PaydenHoskins/Hex_Walker_Project/Kicad_Files/Servo_Board/3D_View.png

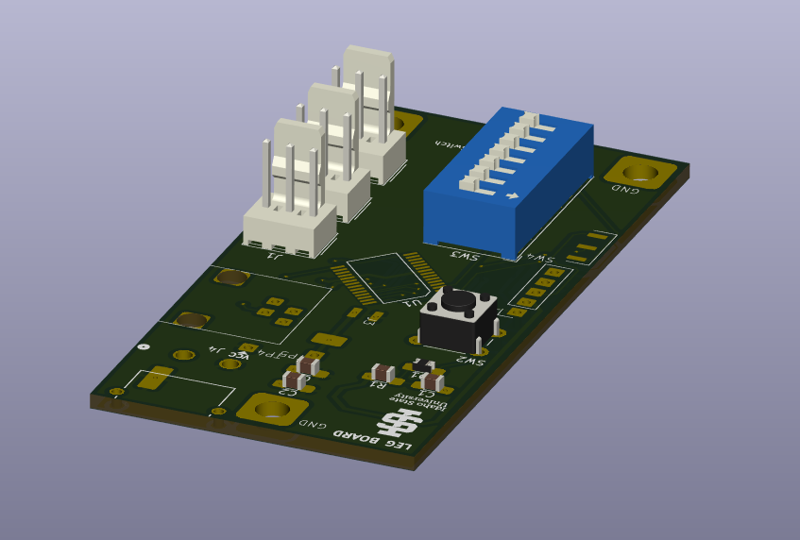
Kicad_Files/Servo_Board/3D_View.png
