PaydenHoskins/Hex_Walker_Project/Kicad_Files/Power_I2C_DistributionBoard/DistBoard.png

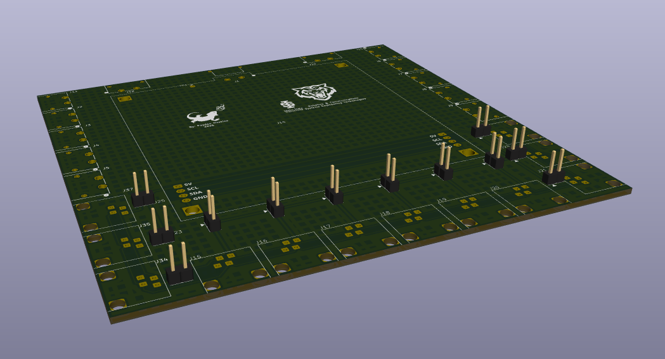
Kicad_Files/Power_I2C_DistributionBoard/DistBoard.png
