PaydenHoskins/Hex_Walker_Project/Pictures/System_Overview.drawio.pdf

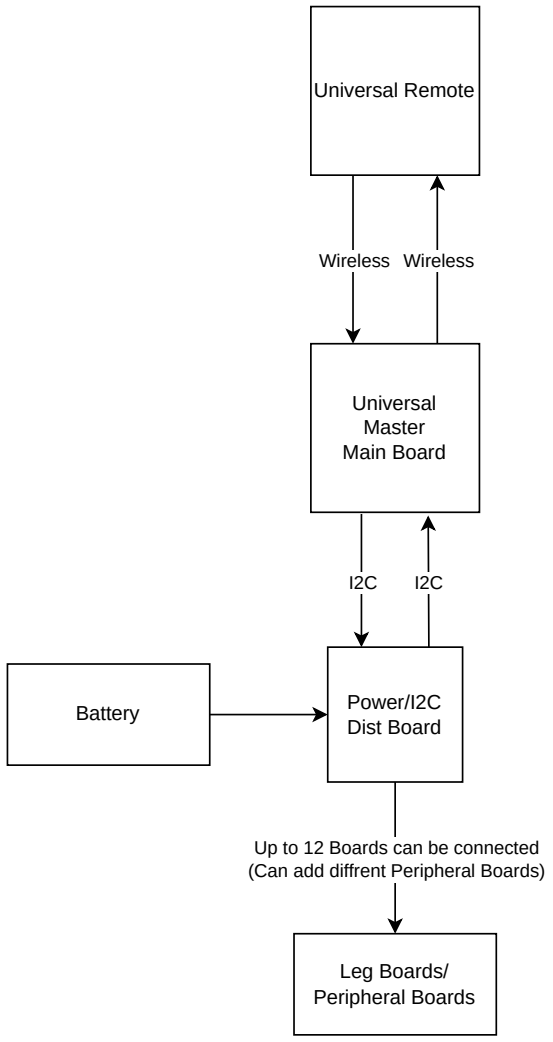
[picture p3: figure]
Universal Remote; Wireless; Universal Master Main Board; Power/I2C Dist Board Battery; Leg Boards/ Peripheral Boards; Up to 12 Boards can be connected (Can add diffrent Peripheral Boards)
