PaydenHoskins/Hex_Walker_Project/Pictures/25Kg_Leg.png

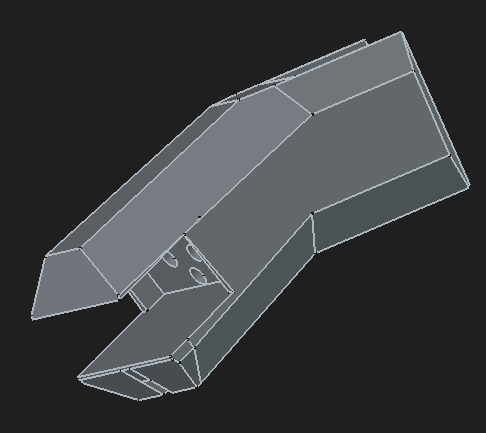
Pictures/25Kg_Leg.png
