PaydenHoskins/Hex_Walker_Project/Pictures/25Kg_Leg_MasterSketch.png

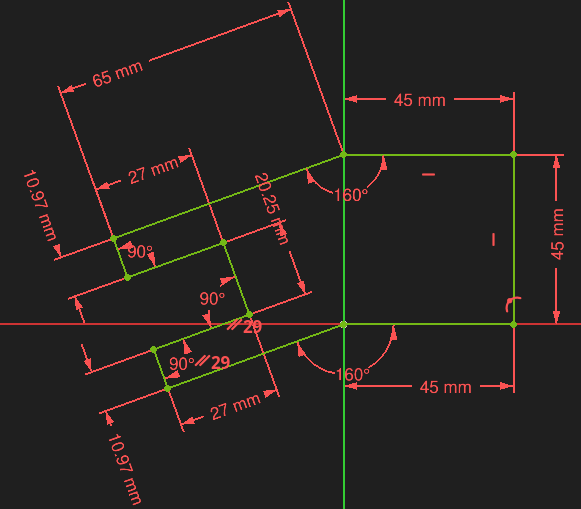
Pictures/25Kg_Leg_MasterSketch.png
