PaydenHoskins/Hex_Walker_Project/Pictures/160Kg_Foot.png

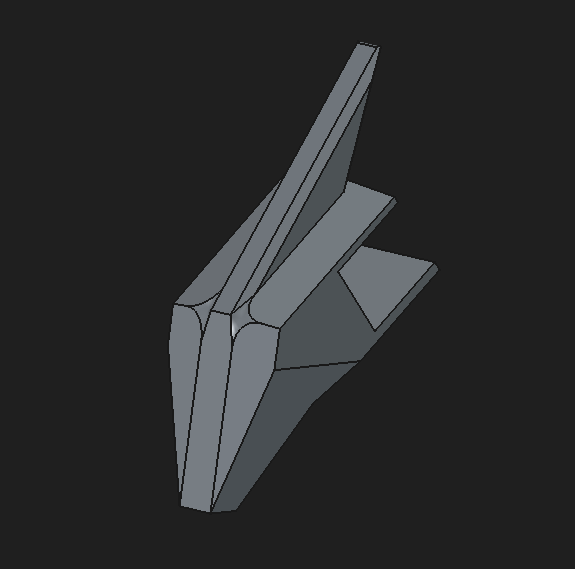
Pictures/160Kg_Foot.png
