PaydenHoskins/Hex_Walker_Project/Pictures/160Kg_Foot_MasterSketch.png

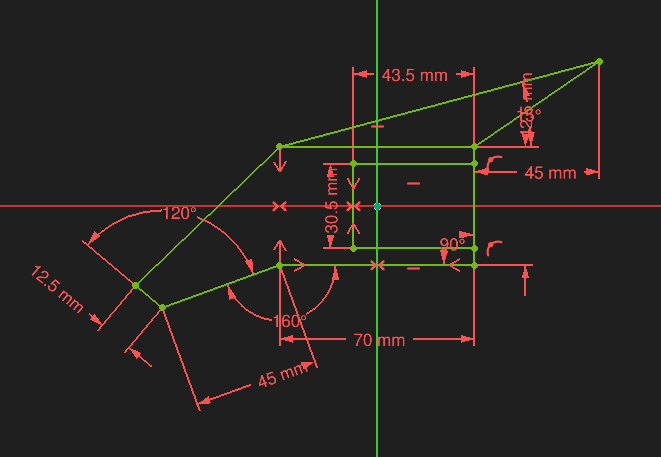
Pictures/160Kg_Foot_MasterSketch.png
