PaydenHoskins/Hex_Walker_Project/Pictures/160Kg_Leg.png

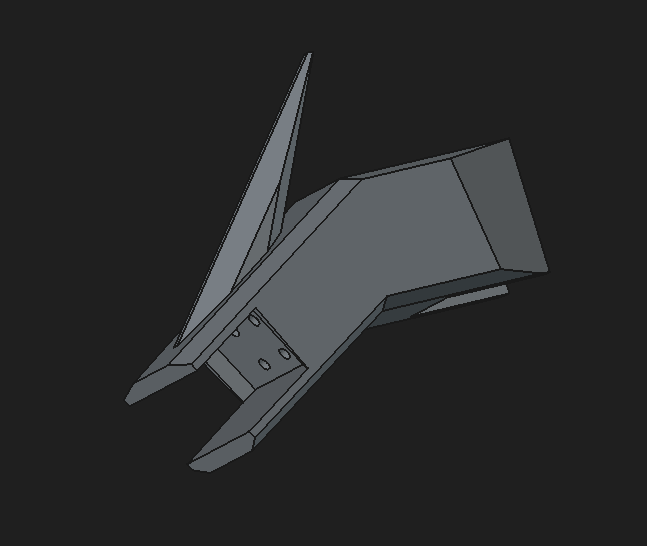
Pictures/160Kg_Leg.png
