PaydenHoskins/Hex_Walker_Project/Pictures/160Kg_Leg_MasterSketch.png

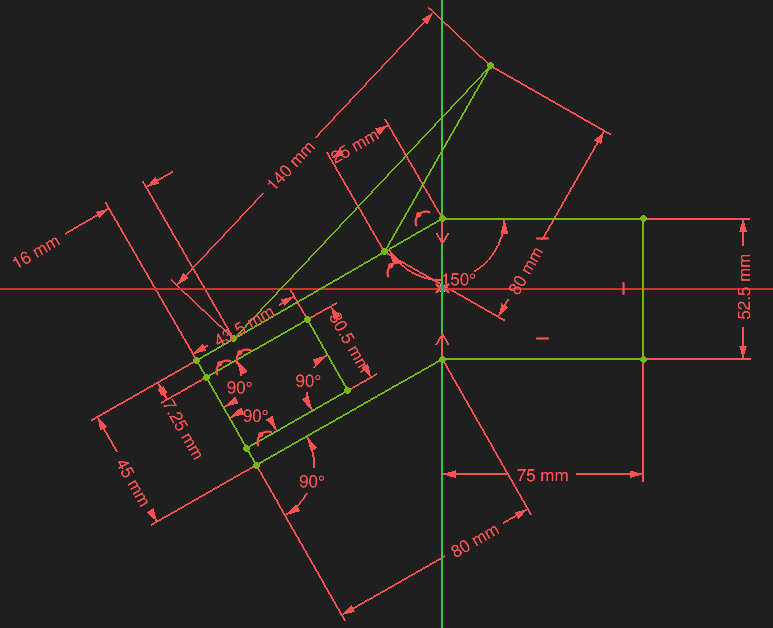
Pictures/160Kg_Leg_MasterSketch.png
