PaydenHoskins/Hex_Walker_Project/Pictures/DistBoard_I2C.png

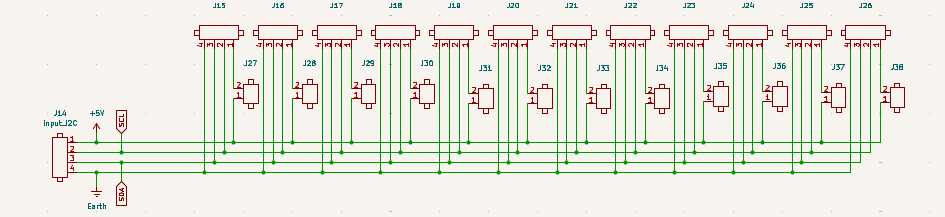
Pictures/DistBoard_I2C.png
