PaydenHoskins/Hex_Walker_Project/Pictures/Power_Board_PCB.png

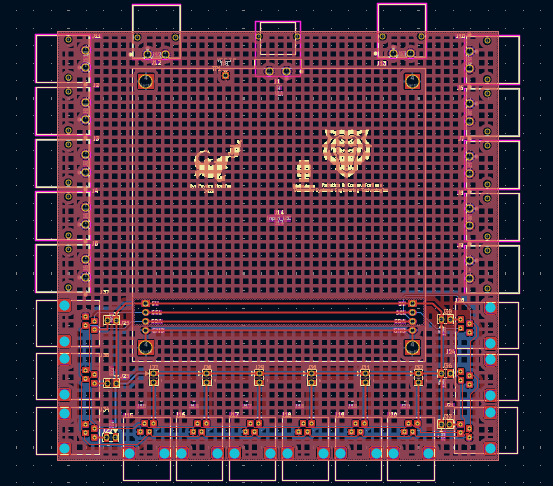
Pictures/Power_Board_PCB.png
