PaydenHoskins/Hex_Walker_Project/Pictures/Power_Board_to_Leg_Board.jpg

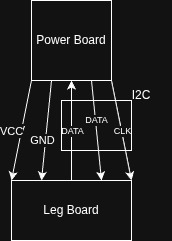
Pictures/Power_Board_to_Leg_Board.jpg
