PaydenHoskins/Hex_Walker_Project/Pictures/Screenshot_20260503_161113.png

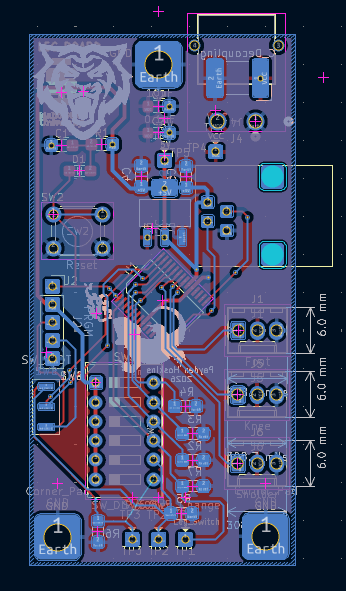
Pictures/Screenshot_20260503_161113.png
