PaydenHoskins/Hex_Walker_Project/Pictures/Servo_Board_Main_Schematic.png

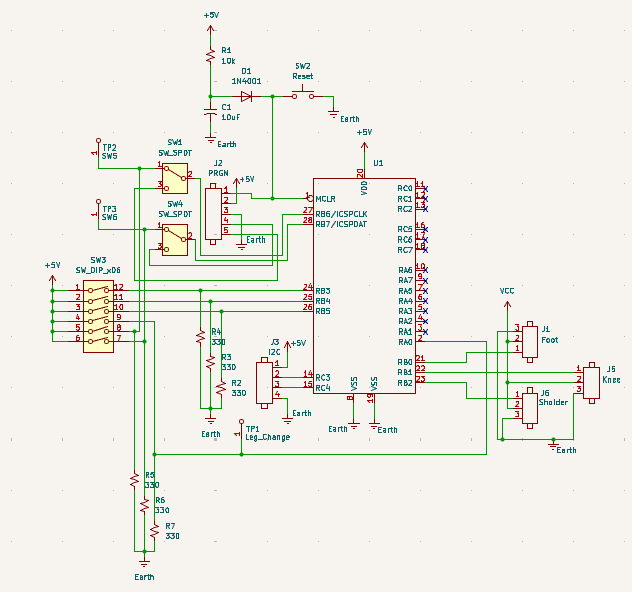
Pictures/Servo_Board_Main_Schematic.png
