PaydenHoskins/Hex_Walker_Project/Pictures/Servo_Board_PowerIn.png

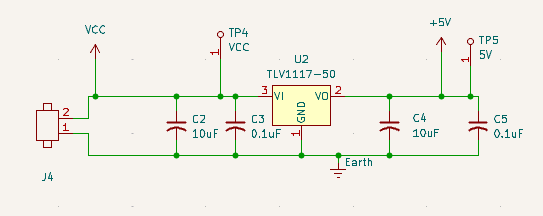
Pictures/Servo_Board_PowerIn.png
