PaydenHoskins/Hex_Walker_Project/Pictures/Servo_Connections.drawio.png

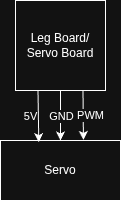
Pictures/Servo_Connections.drawio.png
