PaydenHoskins/Hex_Walker_Project/Pictures/Servo_Signal.jpeg

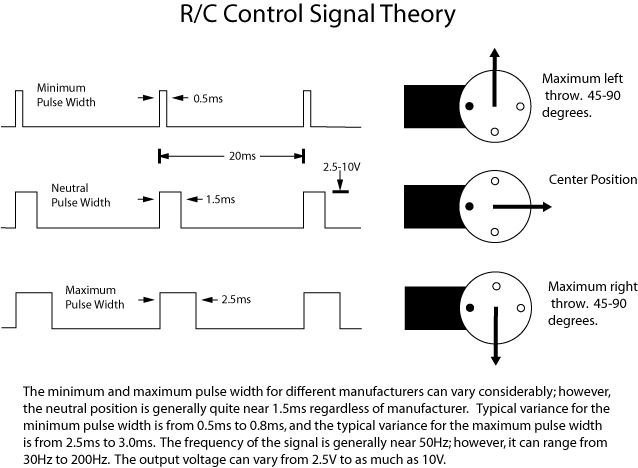
Pictures/Servo_Signal.jpeg
