PaydenHoskins/Hex_Walker_Project/Pictures/Timer2_Int2.png

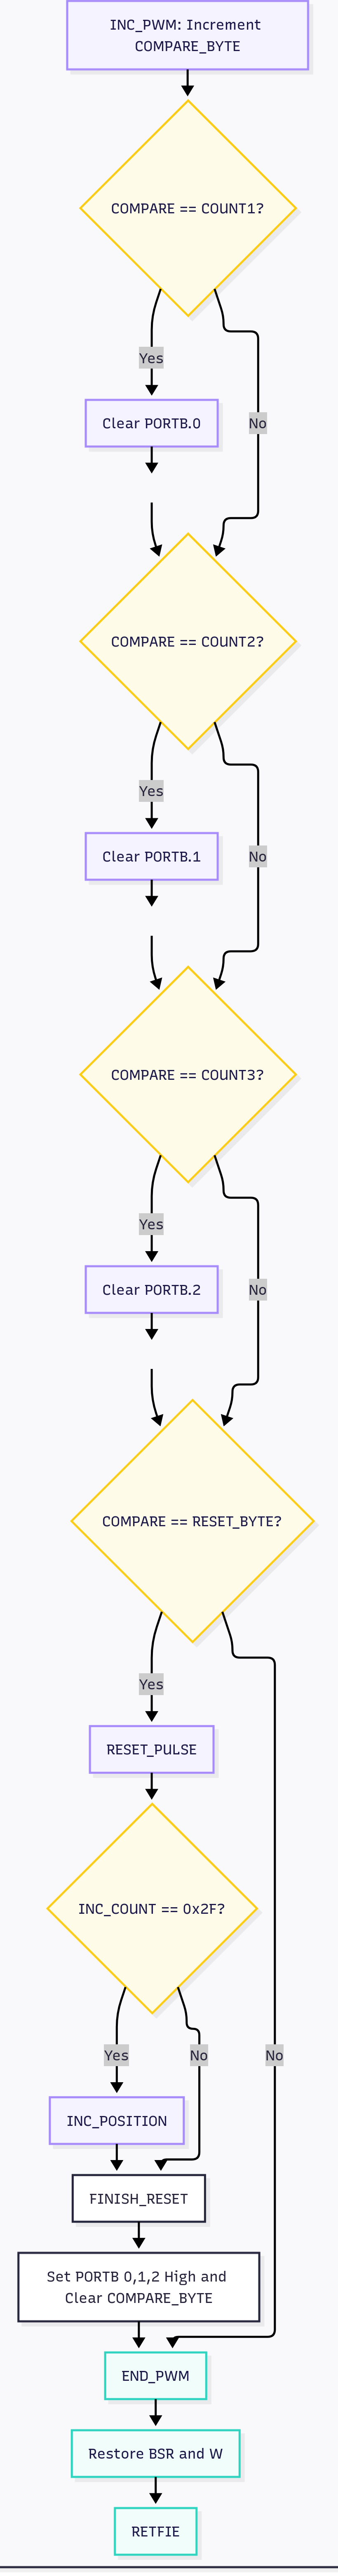
Pictures/Timer2_Int2.png
