PaydenHoskins/Hex_Walker_Project/Pictures/Timer2_Int.png

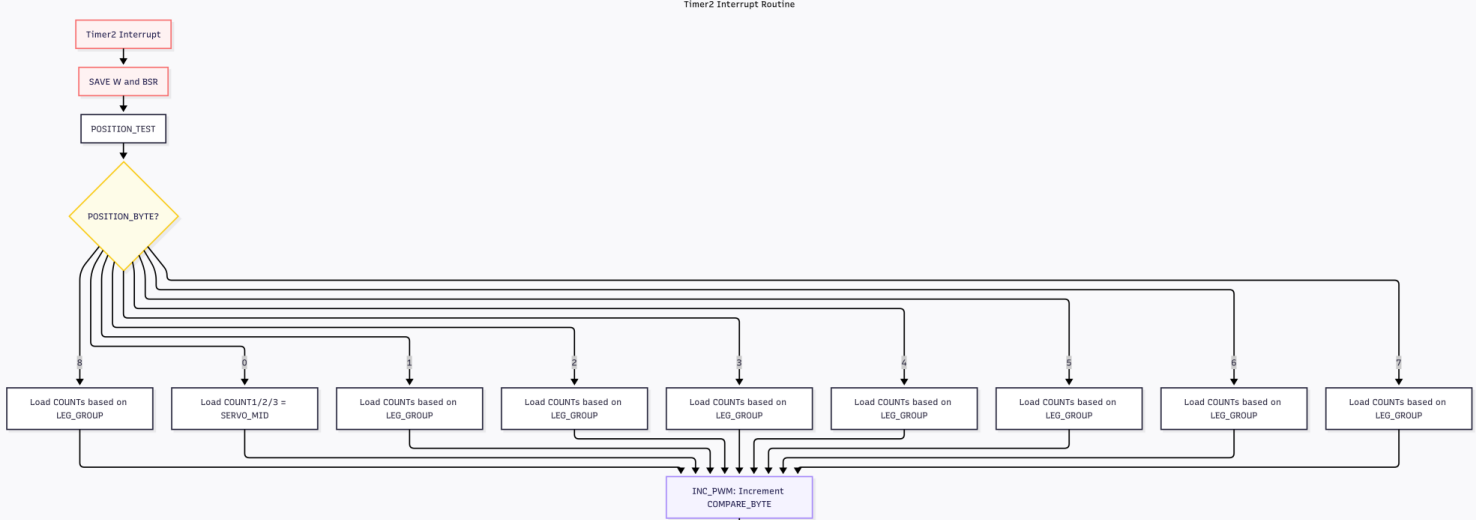
Pictures/Timer2_Int.png
