PaydenHoskins/Hex_Walker_Project/Pictures/Timer2_Start.png

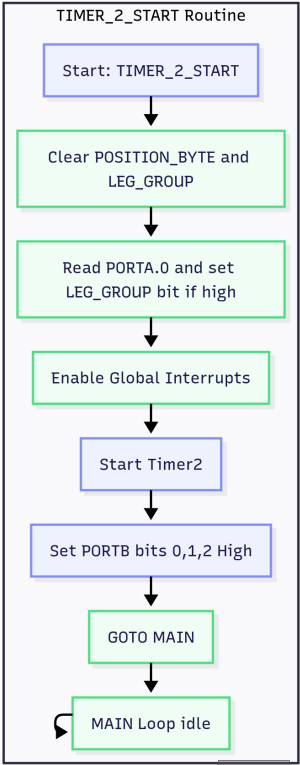
Pictures/Timer2_Start.png
