PaydenHoskins/Hex_Walker_Project/3D_Files/25Kg_Foot-Foot.stl

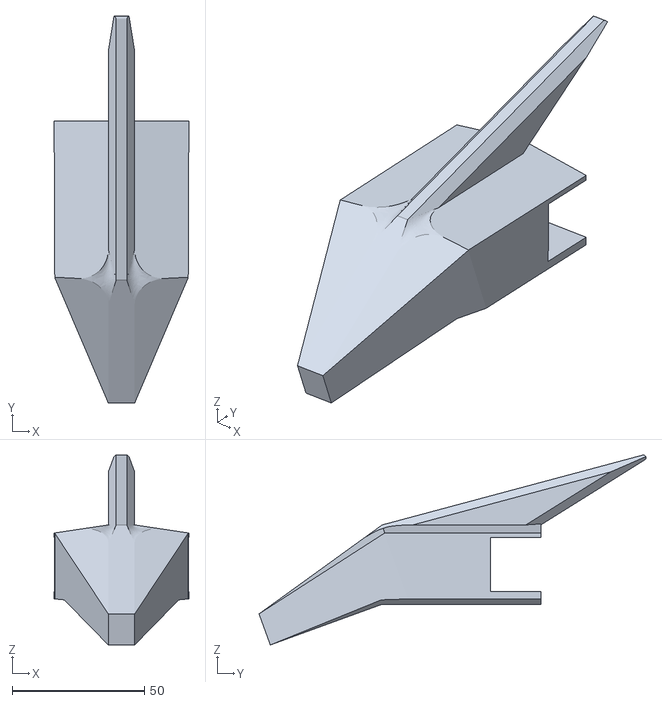
[picture p21: CAD file, 2026-04-27]
3D_Files/25Kg_Foot-Foot.stl
51.0 x 146.4 x 71.8
