PaydenHoskins/Hex_Walker_Project/3D_Files/80_160Kg/160Kg_Foot.FCStd

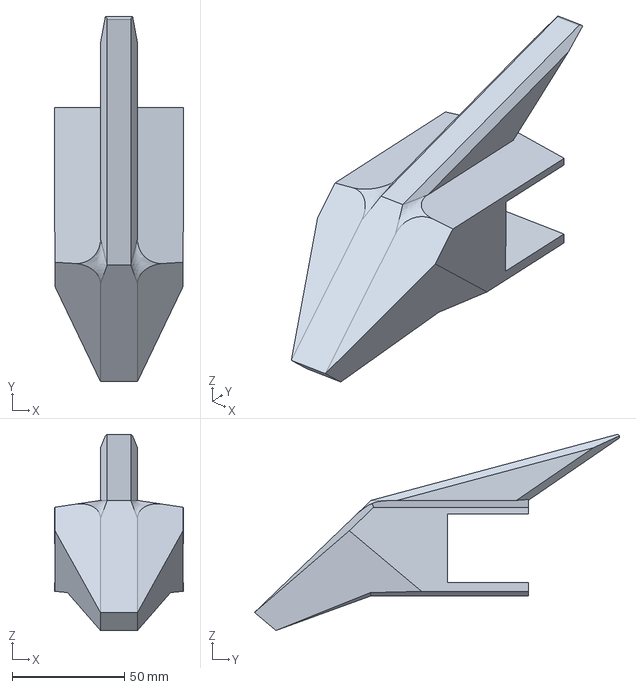
[picture p22: CAD file, 2026-04-27]
3D_Files/80_160Kg/160Kg_Foot.FCStd
57.5 x 162.5 x 87.2 mm
