PaydenHoskins/Hex_Walker_Project/3D_Files/80_160Kg/160Kg_Leg.FCStd

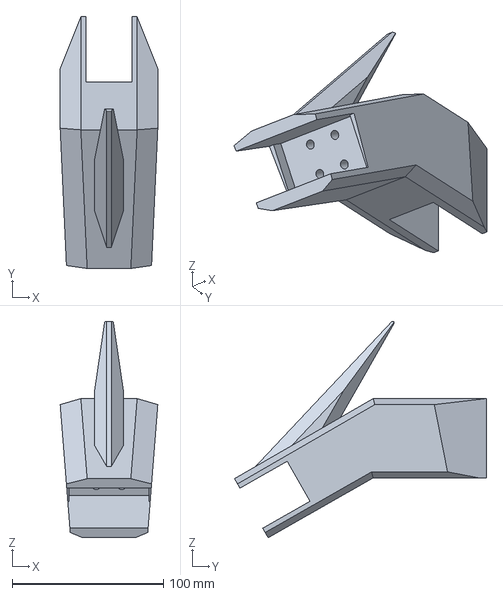
[picture p23: CAD file, 2026-04-27]
3D_Files/80_160Kg/160Kg_Leg.FCStd
64.6 x 166.8 x 143.3 mm
