PaydenHoskins/Hex_Walker_Project/3D_Files/Hex_Leg_HipKneeV2FCStd.FCStd

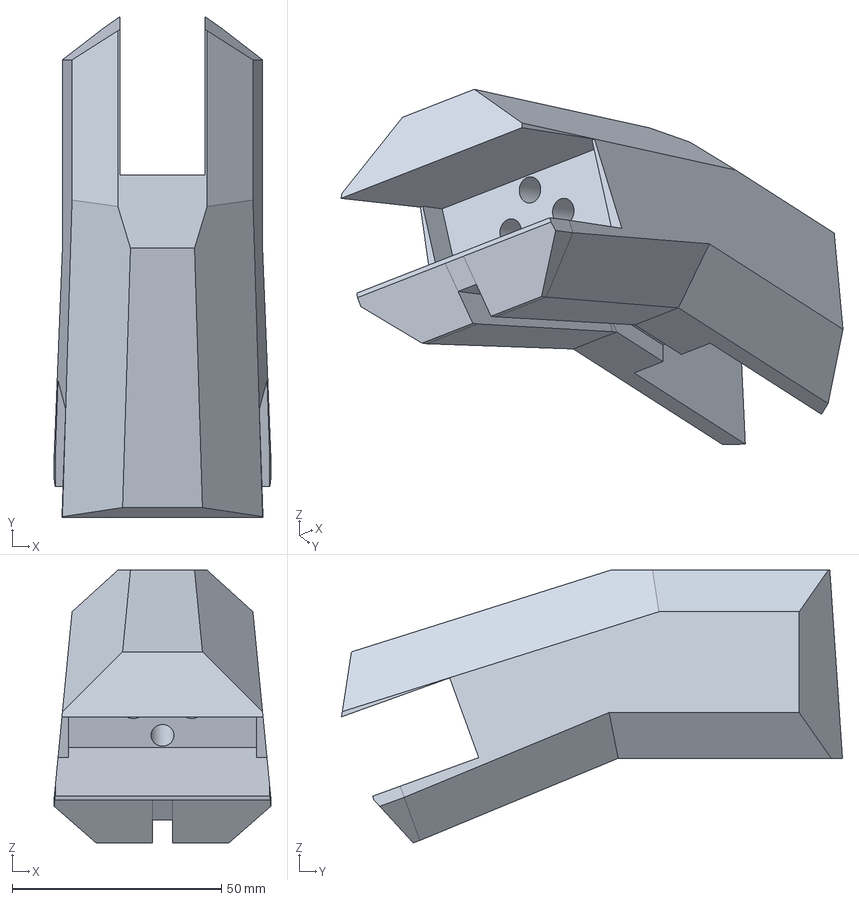
[picture p24: CAD file, 2026-04-27]
3D_Files/Hex_Leg_HipKneeV2FCStd.FCStd
51.8 x 119.8 x 65.2 mm
