PaydenHoskins/Hex_Walker_Project/3D_Files/Hex_Leg_HipToKnee.FCStd

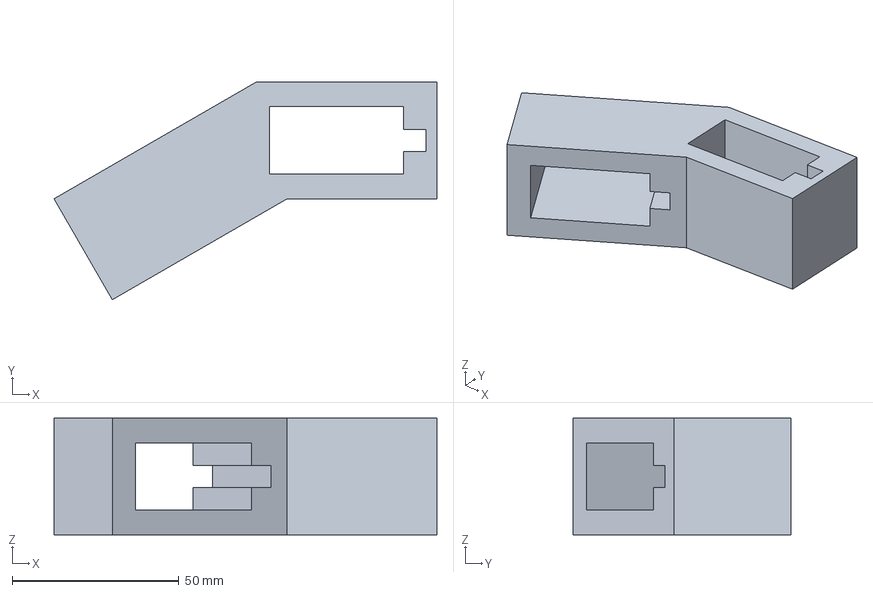
[picture p25: CAD file, 2026-04-27]
3D_Files/Hex_Leg_HipToKnee.FCStd
115.0 x 65.3 x 35.0 mm
