PaydenHoskins/Hex_Walker_Project/3D_Files/Hex_Leg_SholderKneeV2.stl

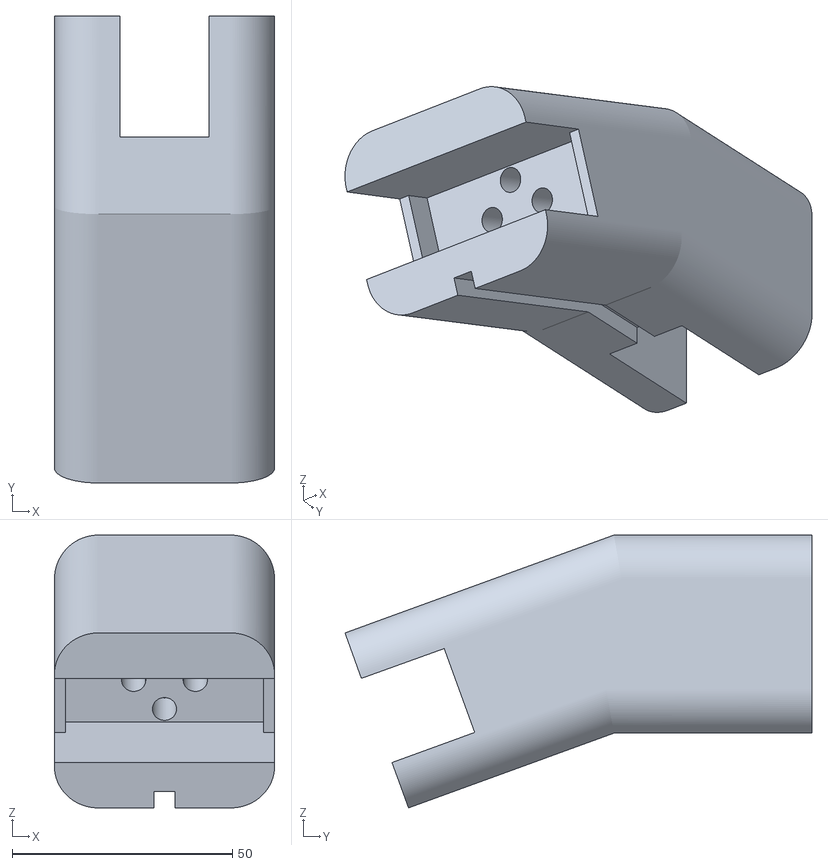
[picture p26: CAD file, 2026-04-27]
3D_Files/Hex_Leg_SholderKneeV2.stl
50.0 x 106.1 x 62.0
