PaydenHoskins/Hex_Walker_Project/(list of files, cad)

Other CAD files:
3D_Files/25Kg_Foot.FCStd
3D_Files/80_160Kg/80_160Kg_Foot-Foot.stl
3D_Files/80_160Kg/80_160Kg_Leg-Body.stl
3D_Files/Hex_Leg_HipKneeV2.2.stl
3D_Files/Hex_Leg_HipKneeV2.1.stl
