PaydenHoskins/Hex_Walker_Project/Kicad_Files/Servo_Board/Servo_Board/Servo_Board.kicad_pcb

## KiCad design Kicad_Files/Servo_Board/Servo_Board/Servo_Board.kicad_pcb (2026-04-27)

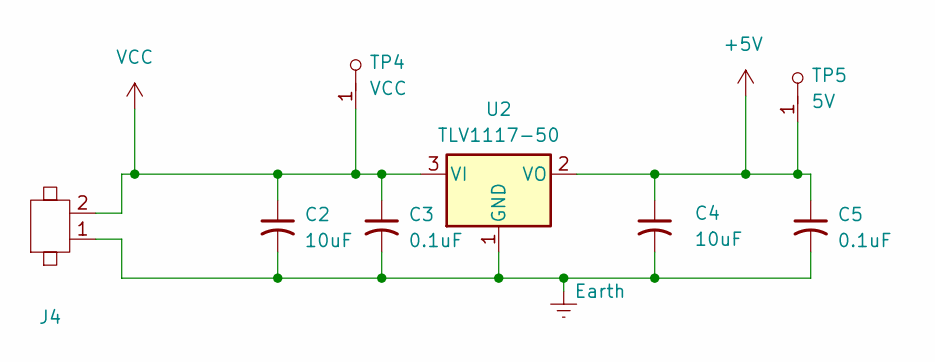
[picture p27: schematic Power.kicad_sch]

Parts:
C2, C4: 10uF; 0805
C3, C5: 0.1uF; 0805
J4: XT30PW-M_AMA
TP4: VCC; TP
TP5: 5V; TP
U2: TLV1117-50; Payden_TLV1117-50

Connections:
+5V: C4.1, C5.1, TP5.1, U2.2 (VO); also elsewhere on the board
Earth: C2.2, C3.2, C4.2, C5.2, J4.1, U2.1 (GND); also elsewhere on the board
VCC: C2.1, C3.1, J4.2, TP4.1, U2.3 (VI); also elsewhere on the board

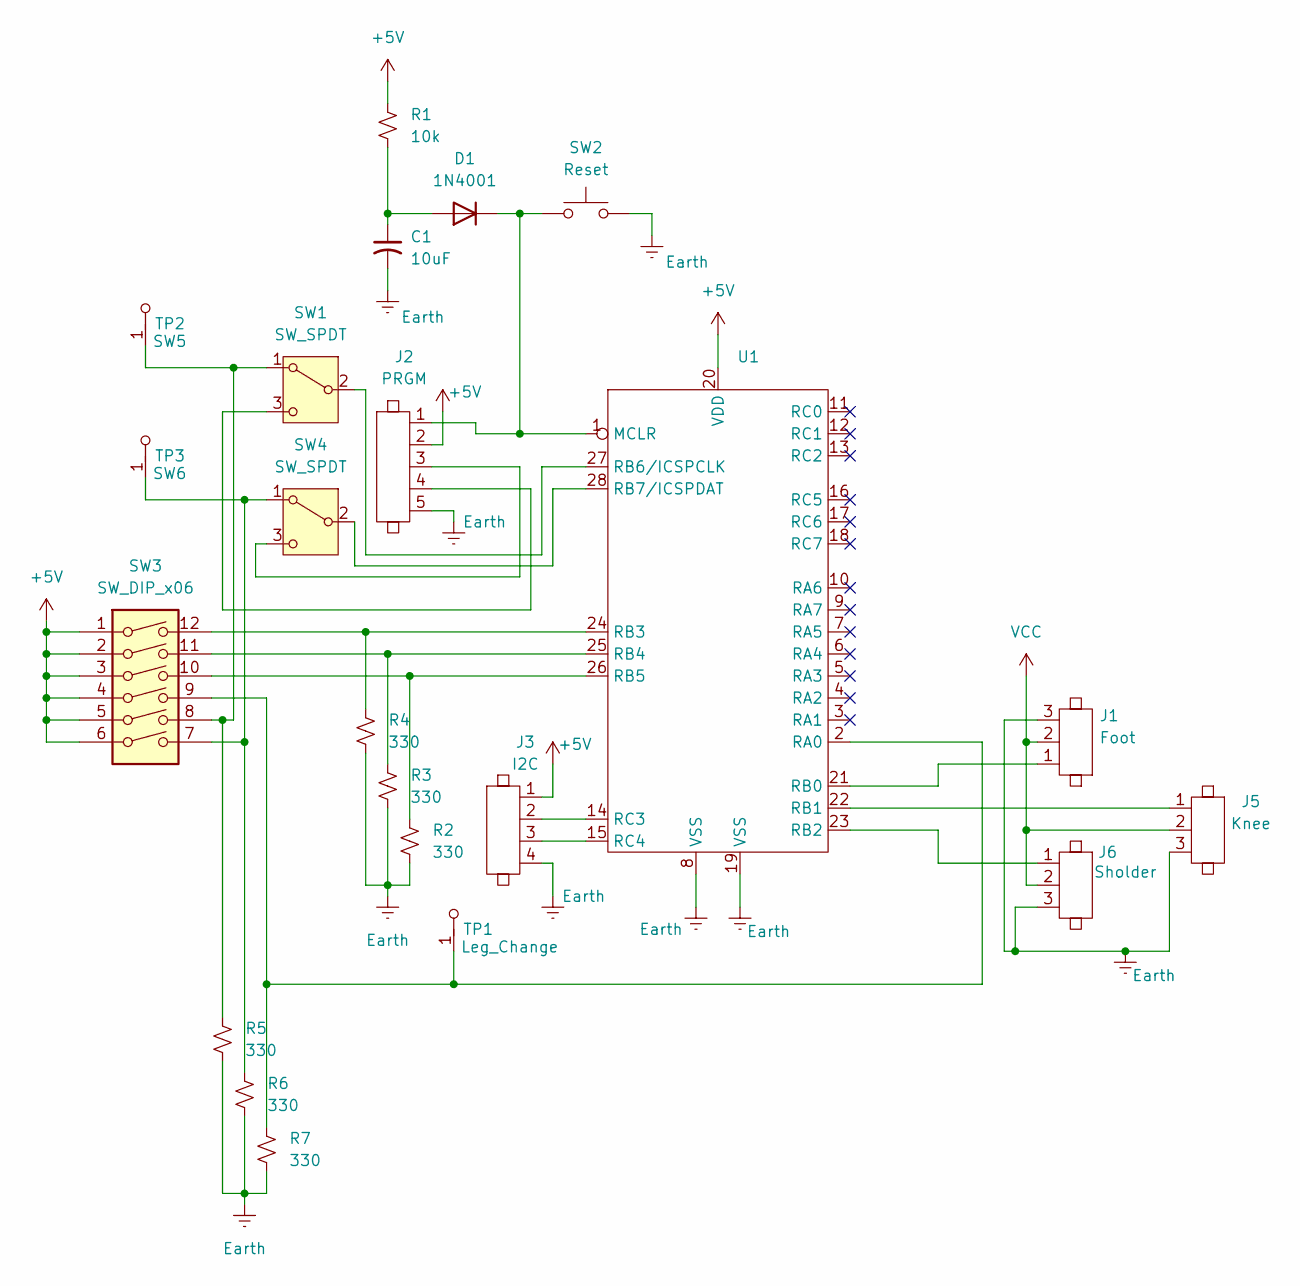
[picture p28: schematic Main_Board.kicad_sch]

Parts:
C1: 10uF; 0805
D1: 1N4001; DIODE_0805
J1: Foot; Header_1x03_P2.54mm_Locking
J2: PRGM; Header_1x5
J3: I2C; Header_1x4
J5: Knee; Header_1x03_P2.54mm_Locking
J6: Sholder; Header_1x03_P2.54mm_Locking
R1: 10k; 0805
R2, R3, R4, R5, R6, R7: 330; 0805
SW1, SW4: SW_SPDT; Payden_SW_SPDT_2x0.8mm
SW2: Reset; SW_PUSH_6mm
SW3: SW_DIP_x06; SW_DIP_SPSTx06_Slide_9.78x17.42mm_W7.62mm_P2.54mm
TP1: Leg_Change; TP
TP2: SW5; TP
TP3: SW6; TP
U1: SSOP-28

Connections:
+5V: J2.2, J3.1, R1.1, SW3.1, SW3.2, SW3.3, SW3.4, SW3.5, SW3.6, U1.20 (VDD); also elsewhere on the board
Earth: C1.2, J1.3, J2.5, J3.4, J5.3, J6.3, R2.2, R3.2, R4.2, R5.2, R6.2, R7.2, SW2.2, U1.8 (VSS), U1.19 (VSS); also elsewhere on the board
unnamed: C1.1, D1.2 (A), R1.2
unnamed: D1.1 (K), J2.1, SW2.1, U1.1 (MCLR)
unnamed: R5.1, SW1.1 (A), SW3.8, TP2.1
unnamed: SW1.2 (B), U1.27 (RB6/ICSPCLK)
unnamed: J2.4, SW1.3 (C)
unnamed: R6.1, SW3.7, SW4.1 (A), TP3.1
unnamed: SW4.2 (B), U1.28 (RB7/ICSPDAT)
unnamed: J2.3, SW4.3 (C)
unnamed: R7.1, SW3.9, TP1.1, U1.2 (RA0)
unnamed: J1.1, U1.21 (RB0)
unnamed: J5.1, U1.22 (RB1)
unnamed: J6.1, U1.23 (RB2)
unnamed: R4.1, SW3.12, U1.24 (RB3)
unnamed: R3.1, SW3.11, U1.25 (RB4)
unnamed: R2.1, SW3.10, U1.26 (RB5)
unnamed: J3.2, U1.14 (RC3)
unnamed: J3.3, U1.15 (RC4)
VCC: J1.2, J5.2, J6.2; also elsewhere on the board

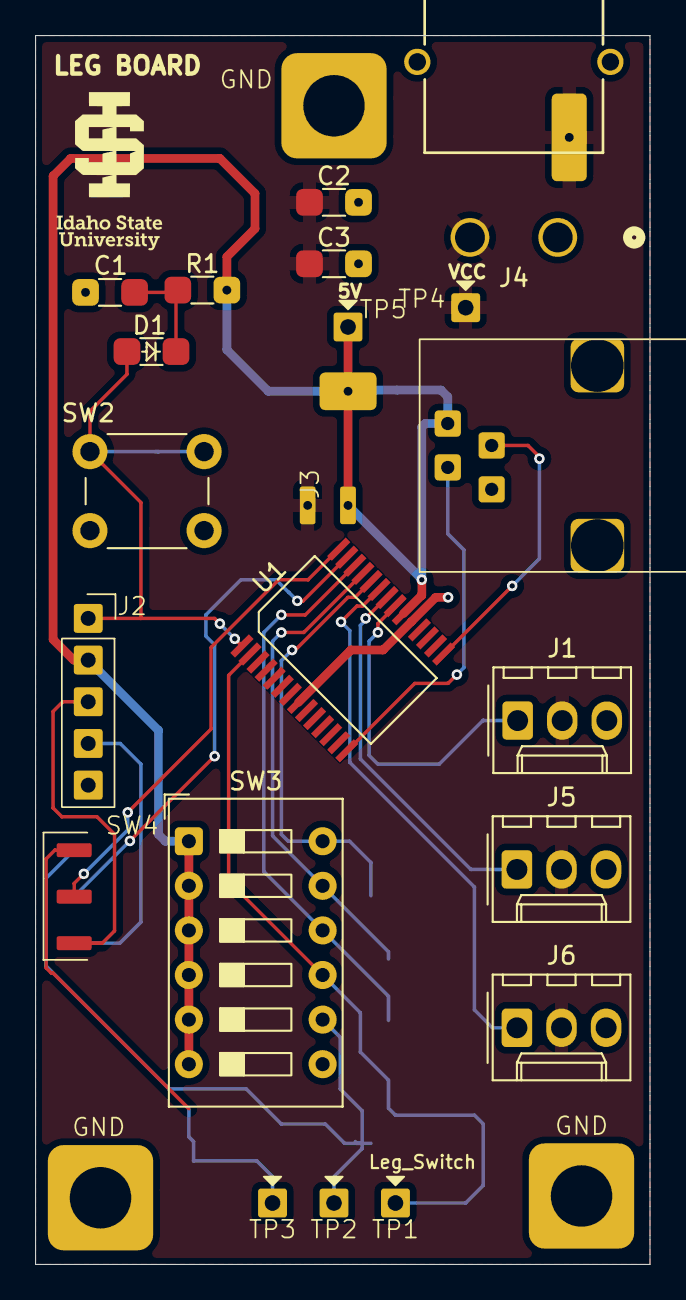
[picture p29: board Servo_Board.kicad_pcb from above]

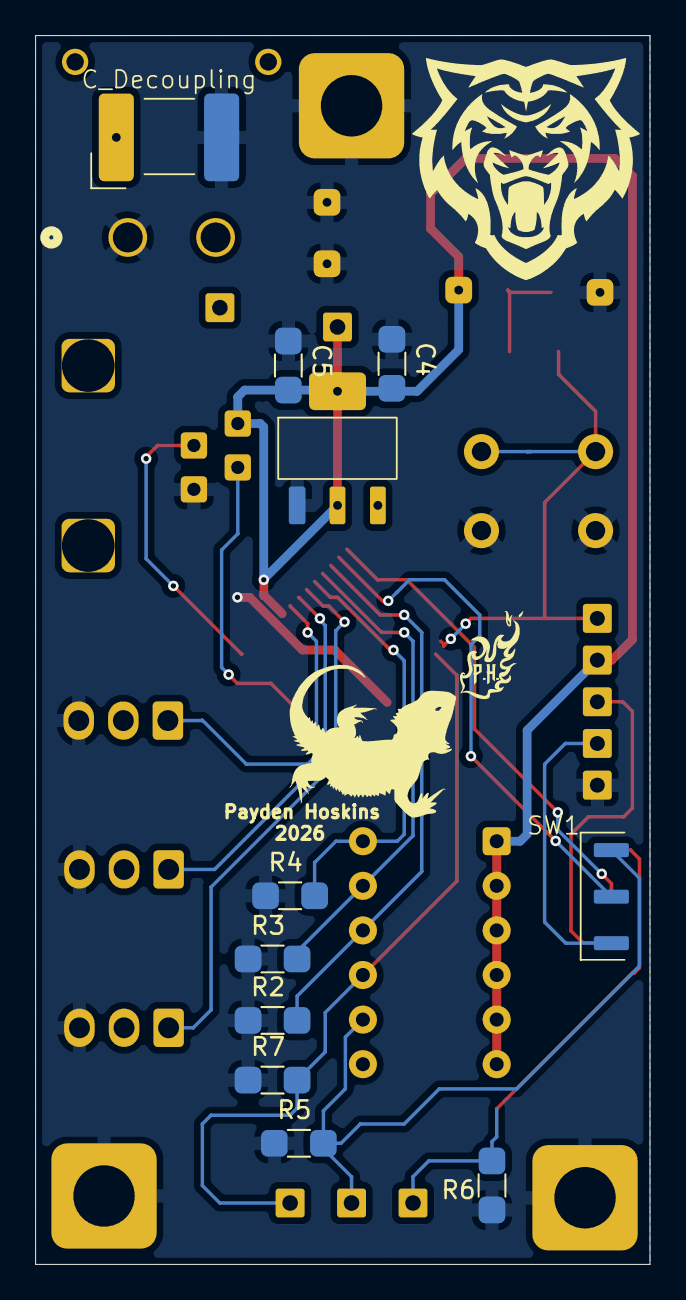
[picture p30: board Servo_Board.kicad_pcb from below]

Board: 2 copper layers, 35.0 x 70.0 mm, 34 parts (11 on the bottom side), 20 nets.

Other parts of the board:
C_Decoupling: 25x17
GND: Corner_Pad
GND#2, GND#3: Corner_Pad

Their connections:
Earth: C_Decoupling.2, GND.1, GND#2.1, GND#3.1; also elsewhere on the board
VCC: C_Decoupling.1; also elsewhere on the board
