PaydenHoskins/Hex_Walker_Project/Kicad_Files/Power_I2C_DistributionBoard/I2C_Power_DistBoard/I2C_Power_DistBoard.kicad_pcb

## KiCad design Kicad_Files/Power_I2C_DistributionBoard/I2C_Power_DistBoard/I2C_Power_DistBoard.kicad_pcb (2026-04-27)

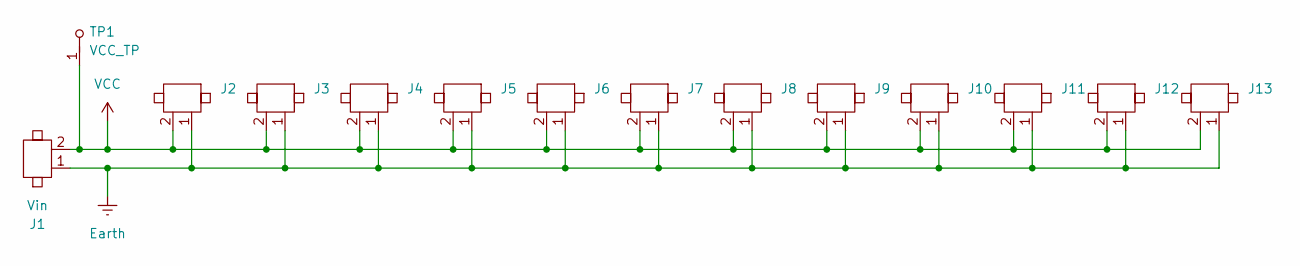
[picture p31: schematic Power.kicad_sch]

Parts:
J1: Vin; XT30PW-M_AMA
J2, J3, J4, J5, J6, J7, J8, J9, J10, J11, J12, J13: CONN_XT30PW-F_AMA
TP1: VCC_TP; TP

Connections:
Earth: J1.1, J2.1, J3.1, J4.1, J5.1, J6.1, J7.1, J8.1, J9.1, J10.1, J11.1, J12.1, J13.1; also elsewhere on the board
VCC: J1.2, J2.2, J3.2, J4.2, J5.2, J6.2, J7.2, J8.2, J9.2, J10.2, J11.2, J12.2, J13.2, TP1.1

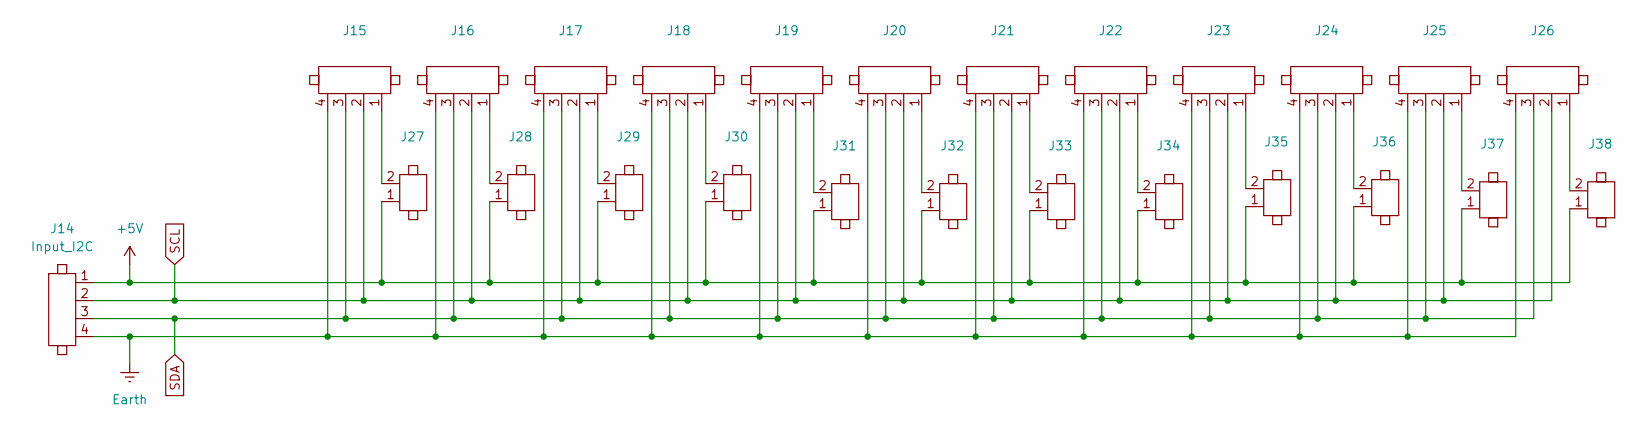
[picture p32: schematic I2C.kicad_sch]

Parts:
J14: Input_I2C; Universal Master Rev A I2C B2B
J15, J16, J17, J18, J19, J20, J21, J22, J23, J24, J25, J26: RJ11
J27, J28, J29, J30, J31, J32, J33, J34, J35, J36, J37, J38: Header_1_x_2

Connections:
+5V: J14.1, J27.1, J28.1, J29.1, J30.1, J31.1, J32.1, J33.1, J34.1, J35.1, J36.1, J37.1, J38.1
Earth: J14.4, J15.4, J16.4, J17.4, J18.4, J19.4, J20.4, J21.4, J22.4, J23.4, J24.4, J25.4, J26.4; also elsewhere on the board
unnamed: J15.1, J27.2
unnamed: J16.1, J28.2
unnamed: J17.1, J29.2
unnamed: J18.1, J30.2
unnamed: J19.1, J31.2
unnamed: J20.1, J32.2
unnamed: J21.1, J33.2
unnamed: J22.1, J34.2
unnamed: J23.1, J35.2
unnamed: J24.1, J36.2
unnamed: J25.1, J37.2
unnamed: J26.1, J38.2
SCL: J14.2, J15.2, J16.2, J17.2, J18.2, J19.2, J20.2, J21.2, J22.2, J23.2, J24.2, J25.2, J26.2
SDA: J14.3, J15.3, J16.3, J17.3, J18.3, J19.3, J20.3, J21.3, J22.3, J23.3, J24.3, J25.3, J26.3

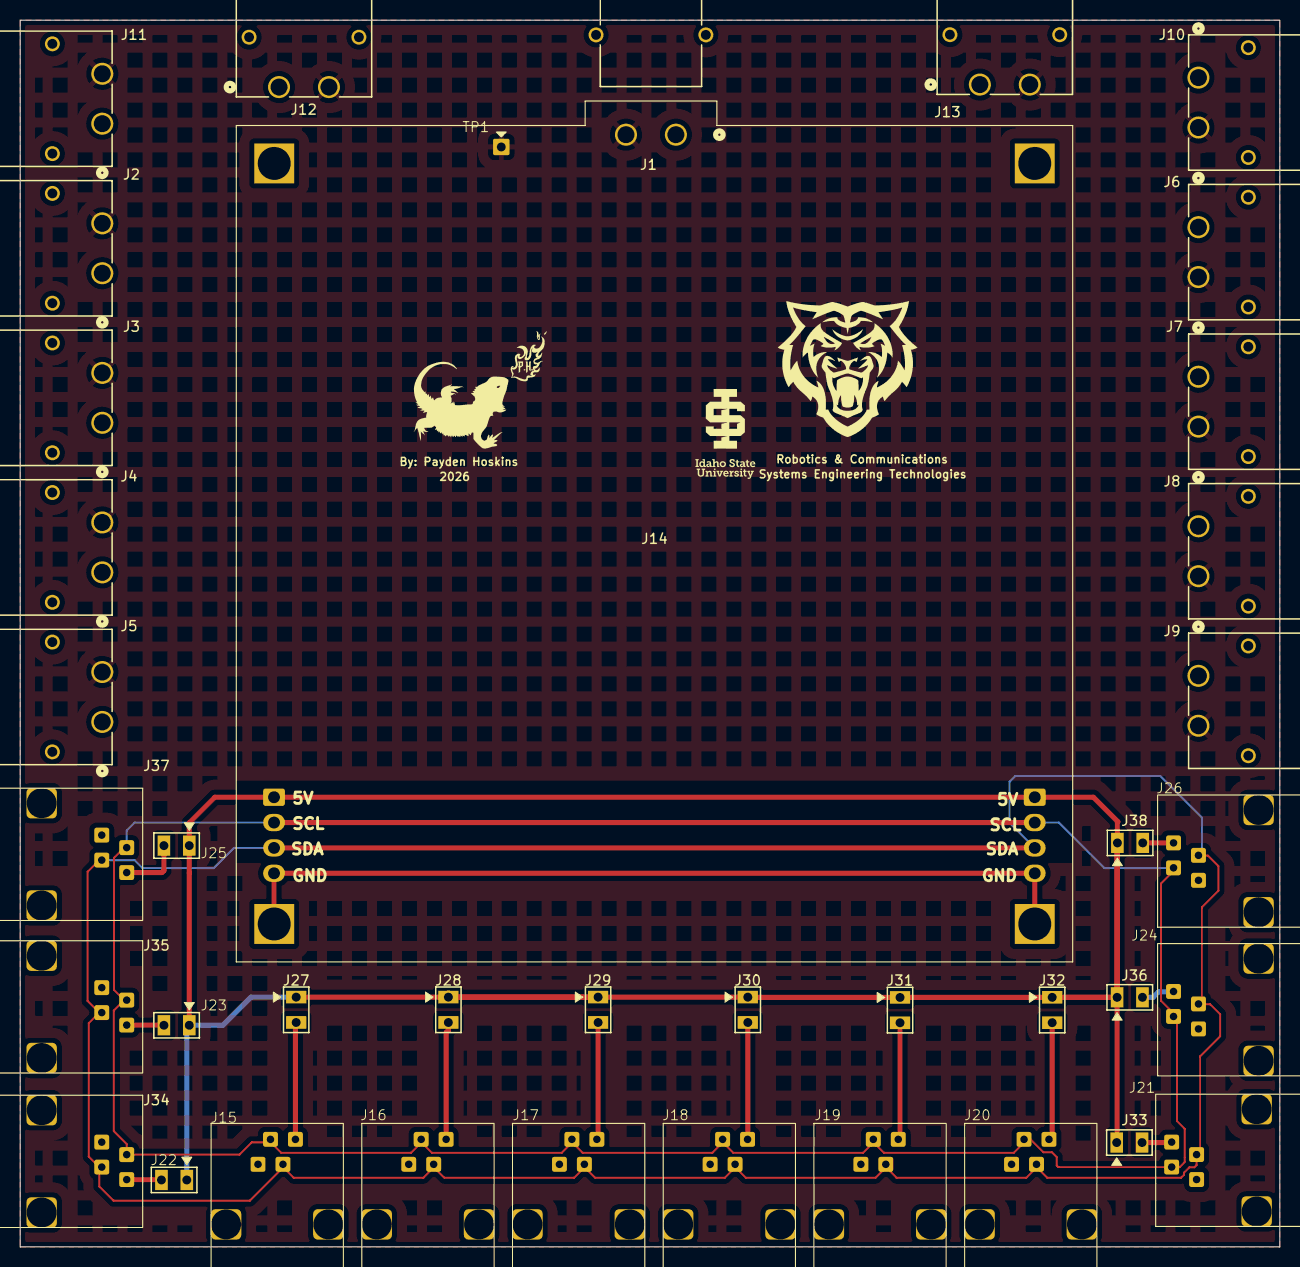
[picture p33: board I2C_Power_DistBoard.kicad_pcb from above]

Board: 2 copper layers, 126.2 x 122.9 mm, 39 parts (0 on the bottom side), 17 nets.
