PaydenHoskins/Hex_Walker_Project/Servo_Drive.X/Servo_Drive_Main.asm

;****************************************************************************
;									    *
;	    File Name: Servo_Drive_Main.asm				    *
;	    Date: 3/19/26						    *
;	    File Version: 1						    *
;	    Author:    Payden Hoskins					    *
;	    Company:   Idaho State Universisty;	RCET			    *
;	    Description: Control Servo Positions based on		    *
;	                 what is sent over I2C				    *
;****************************************************************************
I2C_TEMP	    EQU	H'220'
COMPARE_BYTE	    EQU H'070'
RESET_BYTE	    EQU H'071'
COUNT1		    EQU	H'072' 
COUNT2		    EQU H'073'
COUNT3		    EQU H'074'
TEMP		    EQU H'075'
LEG_GROUP	    EQU H'076'
POSITION_BYTE	    EQU H'077'
W_SAVE		    EQU H'078'
BANK_SAVE	    EQU H'079'
INC_COUNT	    EQU H'07A'
SERVO_MID	    EQU H'07B'
SERVO_MAX	    EQU H'07C'
SERVO_MIN	    EQU H'07D'
SERVO_MIN_FOOT_KNEE EQU	H'07E'   

;******************************************
;Include Files
;******************************************
#include <p16f1788.inc>
#include "pic16f1788_Setup.inc"
#include "I2C_SLAVE.inc"

;******************************************
;CONFIG
;******************************************
    
; CONFIG1
; __config 0xD9EC
 __CONFIG _CONFIG1, _FOSC_INTOSC & _WDTE_SWDTEN & _PWRTE_OFF & _MCLRE_ON & _CP_OFF & _CPD_OFF & _BOREN_OFF & _CLKOUTEN_OFF & _IESO_ON & _FCMEN_OFF
; CONFIG2
; __config 0xFFFF
 __CONFIG _CONFIG2, _WRT_OFF & _VCAPEN_OFF & _PLLEN_ON & _STVREN_OFF & _BORV_LO & _LPBOR_OFF & _LVP_ON

 
;******************************************		
;Interrupt Vectors
;******************************************
    ORG H'00'					
    GOTO SETUP				;RESET CONDITION GOTO SETUP
    
    ORG H'04'
    GOTO INTERRUPT			;Interrupt occur GOTO INTERRUPT
    RETFIE

;******************************************
;Setup Routine
;******************************************
SETUP
    CALL	INITALIZE		;Set Up pic main operation
    CALL	I2C_SETUP
    
    BANKSEL	RCSTA
    BSF		RCSTA,4			;Disable Continous Receive UART
    
    BANKSEL	PORTB
    CLRF	PORTB
    
    CLRF	COMPARE_BYTE
    
    MOVLW	H'14'
    MOVWF	COUNT1
    MOVLW	H'14'
    MOVWF	COUNT2
    MOVLW	H'14'
    MOVWF	COUNT3
    
;SET SERVO POSITONS
    MOVLW	H'0F'
    MOVWF	SERVO_MID
    
    MOVLW	H'11'
    MOVWF	SERVO_MAX
    
    MOVLW	H'0D'
    MOVWF	SERVO_MIN
    
    MOVLW	H'05'
    MOVWF	SERVO_MIN_FOOT_KNEE
    
    MOVLW	H'FF'
    MOVWF	RESET_BYTE
    
    GOTO	TIMER_2_START
    
;******************************************
;Interrupt Service Routine
;******************************************
INTERRUPT
    GOTO	SAVE_REG
    
TIMER_2_START
    CLRF    POSITION_BYTE
    
    CLRF    LEG_GROUP
    BANKSEL PORTA
    CLRF    LEG_GROUP
    BTFSC   PORTA, 0
    BSF	    LEG_GROUP, 0
    
    BANKSEL	INTCON
    BSF		INTCON,7    ;ENABLE GLOBALS
    
    BANKSEL	T2CON
    BSF		T2CON, 2    ;START TIMER 2
    
    BANKSEL	PORTB
    BSF		PORTB, 2
    BSF		PORTB, 1
    BSF		PORTB, 0    ;SET PORT B BIT 0 TO HIGH SO ITS READY FOR PWM	
    
    GOTO	MAIN
MAIN
    
    GOTO MAIN

INC_POSITION
    CLRF    INC_COUNT
    INCF    POSITION_BYTE, 1
    MOVLW   H'09'
    XORWF   POSITION_BYTE, 0
    BANKSEL STATUS
    BTFSS   STATUS, 2
    GOTO    FINISH_RESET
    CLRF    POSITION_BYTE
    MOVLW   H'03'
    MOVWF   POSITION_BYTE
    GOTO    FINISH_RESET
    
;-------W & BANKSEL SAVE-------  
SAVE_REG    
    MOVWF   W_SAVE
    MOVF    BSR, 0
    MOVWF   BANK_SAVE
    GOTO    INTERRUPT_TEST
    
INTERRUPT_TEST
    BANKSEL PIR1
    BTFSC   PIR1,3
    CALL    I2C_RECEIVE 
    BANKSEL PIR1
    BTFSC   PIR1,1
    GOTO    POSITION_TEST
    MOVF	BANK_SAVE, 0
    MOVWF	BSR
    
    MOVF	W_SAVE, 0
    RETFIE
    
;-----------POSITION-----------      
;<editor-fold defaultstate="collapsed" desc="TEST_DIPSWITCH FOR POSITION">
    
POSITION_TEST   
    
    ;BANKSEL PORTB
    CLRF    TEMP
    ;MOVF    PORTB, 0
    MOVF    POSITION_BYTE, 0
    MOVWF   TEMP
    
    ;LSRF    TEMP,1
    ;LSRF    TEMP,1
    ;LSRF    TEMP,1
    
    MOVLW   H'00'
    XORWF   TEMP, 0
    BANKSEL STATUS
    BTFSC   STATUS, 2
    GOTO    POSITION_0
   
    MOVLW   H'01'
    XORWF   TEMP, 0
    BANKSEL STATUS
    BTFSC   STATUS, 2
    GOTO    POSITION_1
    
    MOVLW   H'02'
    XORWF   TEMP, 0
    BANKSEL STATUS
    BTFSC   STATUS, 2
    GOTO    POSITION_2
    
    MOVLW   H'03'
    XORWF   TEMP, 0
    BANKSEL STATUS
    BTFSC   STATUS, 2
    GOTO    POSITION_3
    
    MOVLW   H'04'
    XORWF   TEMP, 0
    BANKSEL STATUS
    BTFSC   STATUS, 2
    GOTO    POSITION_4
    
    MOVLW   H'05'
    XORWF   TEMP, 0
    BANKSEL STATUS
    BTFSC   STATUS, 2
    GOTO    POSITION_5
    
    MOVLW   H'06'
    XORWF   TEMP, 0
    BANKSEL STATUS
    BTFSC   STATUS, 2
    GOTO    POSITION_6
    
    MOVLW   H'07'
    XORWF   TEMP, 0
    BANKSEL STATUS
    BTFSC   STATUS, 2
    GOTO    POSITION_7
    
    MOVLW   H'08'
    XORWF   TEMP, 0
    BANKSEL STATUS
    BTFSC   STATUS, 2
    GOTO    POSITION_8
    GOTO    POSITION_0
    ;</editor-fold> 
    
;<editor-fold defaultstate="collapsed" desc="LEG_SERVO_DATA">
POSITION_0
    ;<editor-fold defaultstate="collapsed" desc="POSITION H'00'">
    MOVF    SERVO_MID, 0   ;MID (FOOT SERVO)
    MOVWF   COUNT1
    MOVF    SERVO_MID, 0    ;MID (JOINT SERVO)
    MOVWF   COUNT2
    MOVF    SERVO_MID, 0    ;MID (SHOLDER SERVO)
    MOVWF   COUNT3
    GOTO    INC_PWM;</editor-fold>

POSITION_1
    ;<editor-fold defaultstate="collapsed" desc="POSITION H'01'">
    MOVF    SERVO_MID, 0   ;(45 DEGREE, LEGS 1,4,5)
    BTFSC   LEG_GROUP, 0
    MOVF    SERVO_MIN_FOOT_KNEE, 0   ;(45 DEGREE, LEGS 2,3,6)
    MOVWF   COUNT1
    
    MOVF    SERVO_MID, 0   ;(45 DEGREE, LEGS 1,4,5)
    BTFSC   LEG_GROUP, 0
    MOVF    SERVO_MIN_FOOT_KNEE, 0   ;MIN (ALL THE WAY UP)
    MOVWF   COUNT2
    
    MOVF    SERVO_MID, 0   ;(45 DEGREE, LEGS 1,4,5)
    BTFSC   LEG_GROUP, 0
    MOVF    SERVO_MID, 0   ;MID (90 DEGREE)
    MOVWF   COUNT3
    GOTO    INC_PWM;</editor-fold>
   
POSITION_2
    ;<editor-fold defaultstate="collapsed" desc="POSTITON H'02'">
    MOVF    SERVO_MID, 0   ;(45 DEGREE, LEGS 1,4,5)
    BTFSC   LEG_GROUP, 0
    MOVF    SERVO_MIN_FOOT_KNEE, 0   ;(45 DEGREE)
    MOVWF   COUNT1
    
    MOVF    SERVO_MID, 0   ;(45 DEGREE, LEGS 1,4,5)
    BTFSC   LEG_GROUP, 0
    MOVF    SERVO_MIN_FOOT_KNEE, 0   ;MIN (ALL THE WAY UP)
    MOVWF   COUNT2
    
    MOVF    SERVO_MID, 0   ;(45 DEGREE, LEGS 1,4,5)
    BTFSC   LEG_GROUP, 0
    MOVF    SERVO_MAX, 0   ;MID (90 DEGREE)
    MOVWF   COUNT3
    GOTO    INC_PWM;</editor-fold>
    
POSITION_3
    ;<editor-fold defaultstate="collapsed" desc="POSTITON H'03'">
    MOVF    SERVO_MID, 0   ;(45 DEGREE, LEGS 1,4,5)
    BTFSC   LEG_GROUP, 0
    MOVF    SERVO_MIN_FOOT_KNEE, 0   ;(45 DEGREE)
    MOVWF   COUNT1
    
    MOVF    SERVO_MID, 0   ;(45 DEGREE, LEGS 1,4,5)
    BTFSC   LEG_GROUP, 0
    MOVF    SERVO_MIN_FOOT_KNEE, 0   ;MIN (ALL THE WAY UP)
    MOVWF   COUNT2
    
    MOVF    SERVO_MIN, 0   ;(45 DEGREE, LEGS 1,4,5)
    BTFSC   LEG_GROUP, 0
    MOVF    SERVO_MAX, 0   ;MID (90 DEGREE)
    MOVWF   COUNT3
    GOTO    INC_PWM;</editor-fold>
    
POSITION_4
    ;<editor-fold defaultstate="collapsed" desc="POSTITON H'04'">
    MOVF    SERVO_MID, 0   ;(45 DEGREE, LEGS 1,4,5)
    BTFSC   LEG_GROUP, 0
    MOVF    SERVO_MIN_FOOT_KNEE, 0   ;MID (FOOT SERVO)
    MOVWF   COUNT1
    
    MOVF    SERVO_MID, 0   ;(45 DEGREE, LEGS 1,4,5)
    BTFSC   LEG_GROUP, 0
    MOVF    SERVO_MIN_FOOT_KNEE, 0   ;MID (JOINT SERVO)
    MOVWF   COUNT2
    
    MOVF    SERVO_MAX, 0   ;(45 DEGREE, LEGS 1,4,5)
    BTFSC   LEG_GROUP, 0
    MOVF    SERVO_MIN, 0   ;MID (90 DEGREE)
    MOVWF   COUNT3
    GOTO    INC_PWM;</editor-fold>
    
POSITION_5
    ;<editor-fold defaultstate="collapsed" desc="POSTITON H'05'">
    MOVF    SERVO_MID, 0   ;(45 DEGREE, LEGS 1,4,5)
    BTFSC   LEG_GROUP, 0
    MOVF    SERVO_MID, 0   ;MID (FOOT SERVO)
    MOVWF   COUNT1
    
    MOVF    SERVO_MID, 0   ;(45 DEGREE, LEGS 1,4,5)
    BTFSC   LEG_GROUP, 0
    MOVF    SERVO_MID, 0   ;MID (JOINT SERVO)
    MOVWF   COUNT2
    
    MOVF    SERVO_MAX, 0   ;(45 DEGREE, LEGS 1,4,5)
    BTFSC   LEG_GROUP, 0
    MOVF    SERVO_MIN, 0   ;MID (90 DEGREE)
    MOVWF   COUNT3
    GOTO    INC_PWM;</editor-fold>
    
POSITION_6
    ;<editor-fold defaultstate="collapsed" desc="POSTITON H'06'">
    MOVF    SERVO_MIN_FOOT_KNEE, 0   ;(45 DEGREE, LEGS 1,4,5)
    BTFSC   LEG_GROUP, 0
    MOVF    SERVO_MID, 0   ;MID (FOOT SERVO)
    MOVWF   COUNT1
    
    MOVF    SERVO_MIN_FOOT_KNEE, 0   ;(45 DEGREE, LEGS 1,4,5)
    BTFSC   LEG_GROUP, 0
    MOVF    SERVO_MID, 0   ;MID (JOINT SERVO)
    MOVWF   COUNT2
    
    MOVF    SERVO_MAX, 0   ;(45 DEGREE, LEGS 1,4,5)
    BTFSC   LEG_GROUP, 0
    MOVF    SERVO_MIN, 0   ;MID (SHOLDER SERVO)
    MOVWF   COUNT3
    GOTO    INC_PWM;</editor-fold>
    
POSITION_7
    ;<editor-fold defaultstate="collapsed" desc="POSTITON H'07'">
    MOVF    SERVO_MIN_FOOT_KNEE, 0   ;(45 DEGREE, LEGS 1,4,5)
    BTFSC   LEG_GROUP, 0
    MOVF    SERVO_MID, 0   ;MID (FOOT SERVO)
    MOVWF   COUNT1
    
    MOVF    SERVO_MIN_FOOT_KNEE, 0   ;(45 DEGREE, LEGS 1,4,5)
    BTFSC   LEG_GROUP, 0
    MOVF    SERVO_MID, 0   ;MID (JOINT SERVO)
    MOVWF   COUNT2
    
    MOVF    SERVO_MIN, 0   ;(45 DEGREE, LEGS 1,4,5)
    BTFSC   LEG_GROUP, 0
    MOVF    SERVO_MAX, 0   ;MID (SHOLDER SERVO)
    MOVWF   COUNT3
    GOTO    INC_PWM;</editor-fold>
    
POSITION_8
    ;<editor-fold defaultstate="collapsed" desc="POSTITON H'08'">
    MOVF    SERVO_MID, 0   ;(45 DEGREE, LEGS 1,4,5)
    BTFSC   LEG_GROUP, 0
    MOVF    SERVO_MID, 0   ;MID (FOOT SERVO)
    MOVWF   COUNT1
    
    MOVF    SERVO_MID, 0   ;(45 DEGREE, LEGS 1,4,5)
    BTFSC   LEG_GROUP, 0
    MOVF    SERVO_MID, 0   ;MID (JOINT SERVO)
    MOVWF   COUNT2
    
    MOVF    SERVO_MIN, 0   ;(45 DEGREE, LEGS 1,4,5)
    BTFSC   LEG_GROUP, 0
    MOVF    SERVO_MAX, 0   ;MID (SHOLDER SERVO)
    MOVWF   COUNT3
    GOTO    INC_PWM;</editor-fold>
    
    ;</editor-fold>  

INC_PWM    
    INCF	COMPARE_BYTE, 1
    
    MOVF	COMPARE_BYTE, 0
    XORWF	COUNT1, 0
    
    BANKSEL	STATUS
    BTFSC	STATUS, 2
    GOTO	COUNT1_EQUAL
    
COUNT2_TEST
    
    MOVF	COMPARE_BYTE, 0
    XORWF	COUNT2, 0
    
    BANKSEL	STATUS
    BTFSC	STATUS, 2
    GOTO	COUNT2_EQUAL
    
COUNT3_TEST    
    
    MOVF	COMPARE_BYTE, 0
    XORWF	COUNT3, 0
    
    BANKSEL	STATUS
    BTFSC	STATUS, 2
    GOTO	COUNT3_EQUAL
    
RESET_TEST    
    
    MOVF	COMPARE_BYTE, 0
    XORWF	RESET_BYTE, 0
    
    BANKSEL	STATUS
    BTFSC	STATUS, 2
    GOTO	RESET_PULSE
    GOTO	END_PWM
    
;PW_END   
;<editor-fold defaultstate="collapsed" desc="THIS RUNS WHEN THE COMPARE BYTE = THE COUNT BYTE">
    
COUNT1_EQUAL
    BANKSEL	PORTB
    BCF		PORTB, 0
    GOTO	COUNT2_TEST
    
COUNT2_EQUAL
    BANKSEL	PORTB
    BCF		PORTB, 1
    GOTO	COUNT3_TEST
    
COUNT3_EQUAL
    BANKSEL	PORTB
    BCF		PORTB, 2
    GOTO	RESET_TEST    ;</editor-fold>
 
RESET_PULSE
    BANKSEL	PORTB
    BTFSC	PORTB, 5    ;IF PORTB5 IS SET THEN AUTO LEG STEP STARTS
    INCF	INC_COUNT, 1
    
    MOVLW	H'2F'
    XORWF	INC_COUNT, 0
    BANKSEL	STATUS
    BTFSC	STATUS, 2
    GOTO	INC_POSITION

FINISH_RESET 
    BANKSEL	PORTB
    BSF		PORTB, 0
    BSF		PORTB, 1
    BSF		PORTB, 2
    
    CLRF	COMPARE_BYTE
    GOTO	END_PWM
    
END_PWM
    BANKSEL	PIR1
    BCF		PIR1, 1
    
    
    RETFIE
;------------------------------  
   
    END  
