PaydenHoskins/Hex_Walker_Project/(commit log)

2026-03-18 uses the I2C from the master reciver to act as a easy Master I2C Tester. -PH
2026-03-18 The 3-18-26 version of the servo contoller board, the I2C saves but only byte 2 of the respected addresses saves properly. -PH
2026-03-19 New version of the 03-18-26 code, issue seemes to be the I2C recive gets lost and once it catches up it starts writing the bits in the wrong registers, need to streamline code and determine the best 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
2026-03-19 still dosent work so im going to move onto getting a servo code to move the legs
2026-03-20 got a functioning pwm on a pic to drive a servo. -PH
2026-03-31 code now has all the leg positions but the positions 8 and 9 on legs 1-4-5 seem to get lost and stuck so i need to rework how it determines what legs were selected and when to determine the position 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
    [Servo_Drive_Main.asm]
2026-03-31 fixed the issue where legs 1,4,5 wold break and then also added a few more positions to make the sequence complete. Now a line of code needs to be added to use a timer to increment the position. -pay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
    [Servo_Drive_Main.asm]
2026-04-02 remade the positions and added an automatic step process so that i can visually watch both legs work together. Payden H-
2026-04-27 removed file that is no longer used to remove confusion on what is the servo board code. -Payden H
2026-04-27 added all the files for the leg and foot for both 25kg and 80/160kg servos. -Payden H
    [160Kg_Foot.FCStd, 160Kg_Leg.FCStd, 25Kg_Foot-Foot.stl, 25Kg_Foot.FCStd, 80_160Kg_Foot-Foot.stl, 80_160Kg_Leg-Body.stl, Hex_Leg_HipKneeV2.1.stl, Hex_Leg_HipKneeV2.2.stl]
2026-04-27 added all the Kicad files (these are the updated board that have been fixed since we got the old ones. -Payden H)
    [I2C.kicad_sch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]
2026-05-04 Added more photos to the photos folder that pertain to the project, also added new code registers to make tuning of legs easier. -Payden H
2026-05-04 Added more photos to the photos folder.Updated the Universal Receiver to send the servo leg data and made the servo boards read it and change to those positions. The universal master will need to be 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
